davidasailor/PiForBoat/Diagrams/DataFlowDiagram.pptx

Data Flow Diagram

Web clients

Fridge Temp

Atmega328p

Home based server

Other banks V

RPMs

MFD

Pi Pico

Pi

Shunt

House Loads

Smart Shunt

House V, I, T

VOC’s

Bilge

NMEA Data

Water Levels

Temps
