davidasailor/PiForBoat/Diagrams/HighLevelTopology.pptx

High Level Topology

Smart Shunt for all
loads & chargers

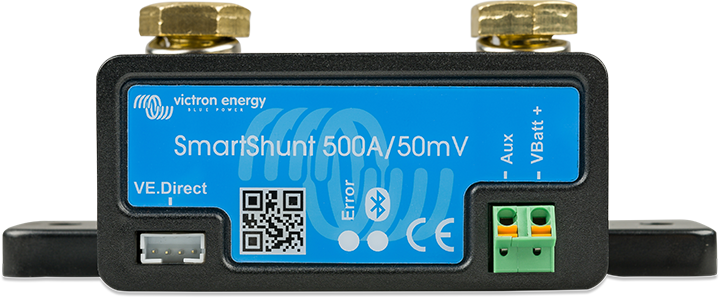
[picture p1: figure]
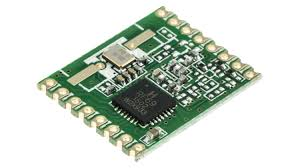
[picture p2: figure]

RFM69HCW

RFM69HCW

SPI + Int

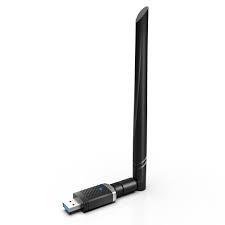
[picture p3: figure]

Wifi to marina
or hotspot

MFD Chartplotter

USB

UART

SPI

DS18B20
Refrigerator

Atmega328p

RFM69HCW

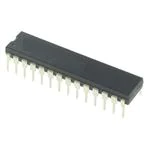
[picture p4: figure]
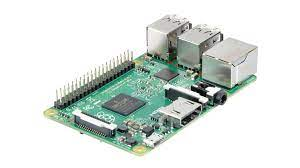
[picture p5: figure]
RASP PI 2 B 1.2 | Raspberry Pi 2 Model B v1.2 1GB | Distrelec Export Shop

Pi Model 2 B

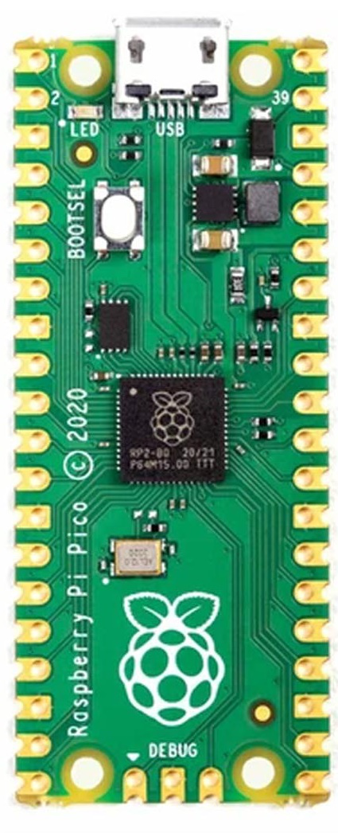
[picture p6: figure]

I2C

Ethernet

House Bank

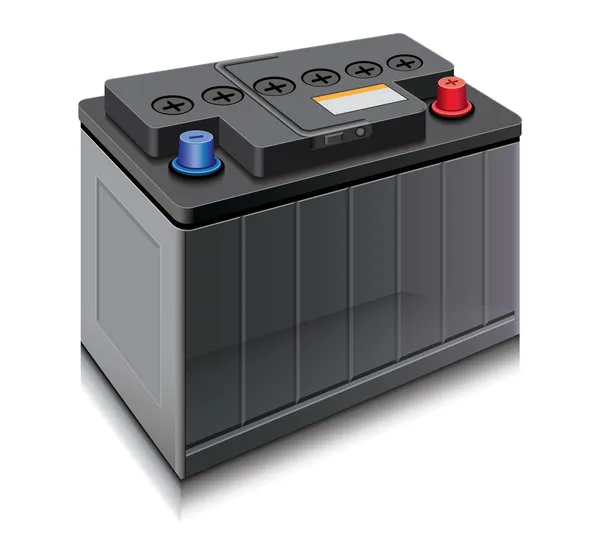
[picture p7: figure]

I2C

GPIO

Water Tank 1
Sensor

ADS1115

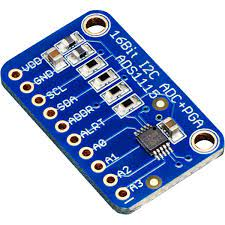
[picture p8: figure]
Adafruit 1085 ADC 16-bit Analogue to Digital Converter 4 Channel (ADS1115) | Rapid Online

USB

NMEA2K

Pi Pico

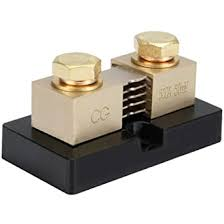
[picture p9: figure]

Water Tank 2
Sensor

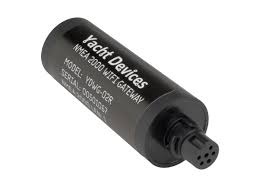
[picture p10: figure]
NMEA 2000 Wi-Fi Gateway YDWG-02 – Yacht Devices U.S. LLC

NMEA 2000 bridge

Shunt for house loads

Opto-Isolator

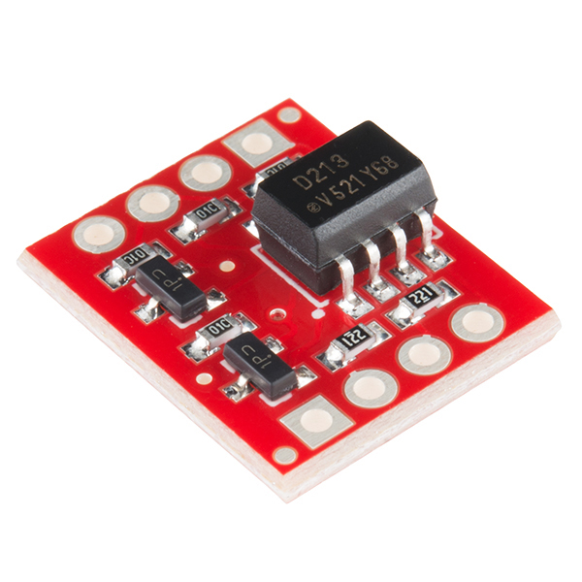
[picture p11: figure]
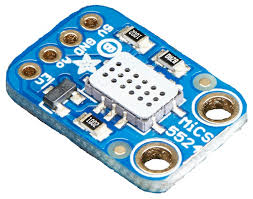
[picture p12: figure]

1-Wire

Engine Bank

MiCS5524
VOC Sensor

Bilge pump sensor

GPIO

Tach Out

DS18B20
Cabin

DS18B20
Engine

- All lines colored red have appropriate voltage dividers
- Power for Smart Shunt, Pico, and Pi not illustrated

DS18B20
Exhaust

Thruster Bank

ADS1115

Alternator

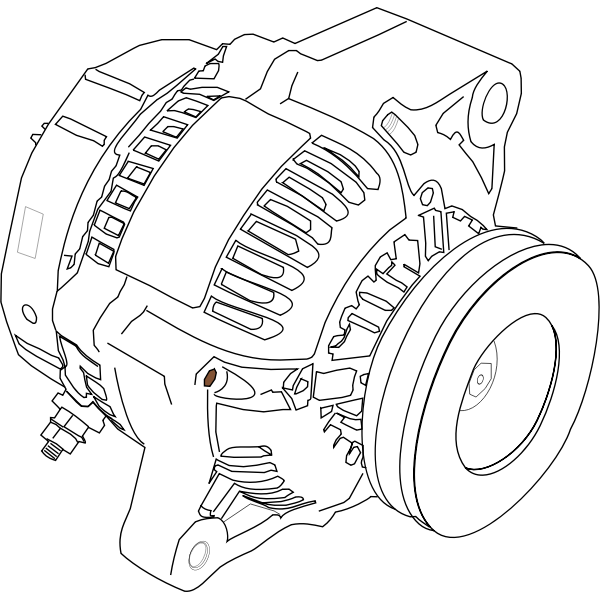
[picture p13: figure]
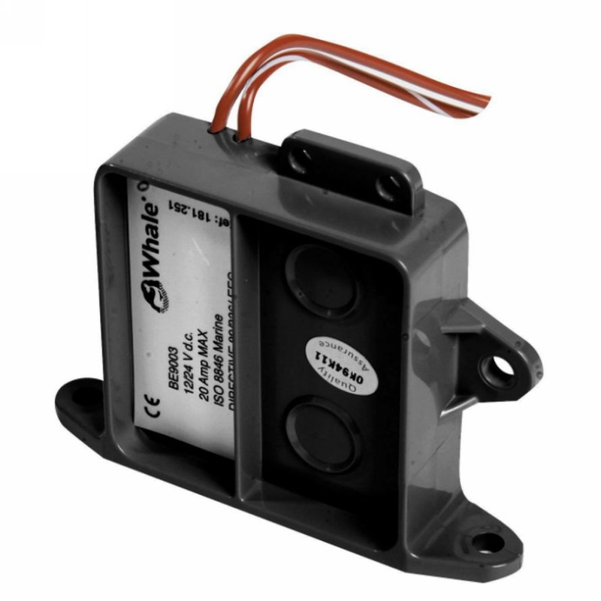
[picture p14: figure]
