davidasailor/PiForBoat/Screenshots/ElectricalDashboardTop.png

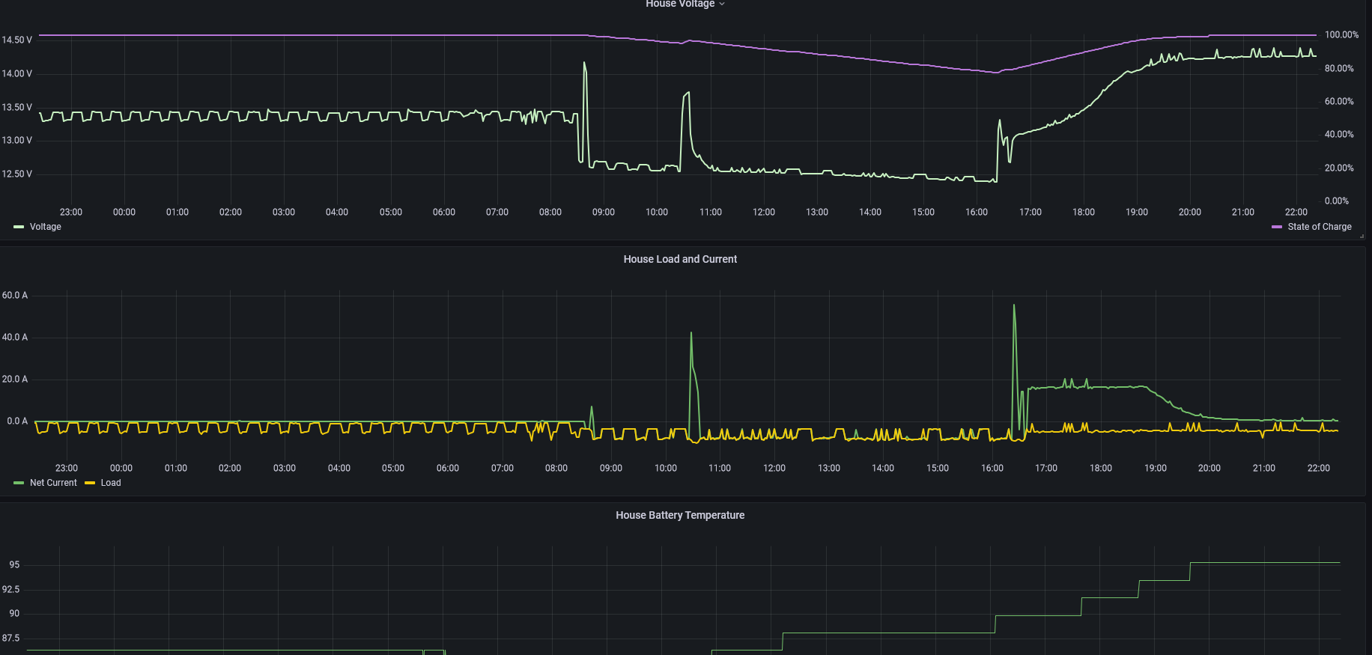
Screenshots/ElectricalDashboardTop.png
