davidasailor/PiForBoat/Screenshots/MainDashboardLower.png

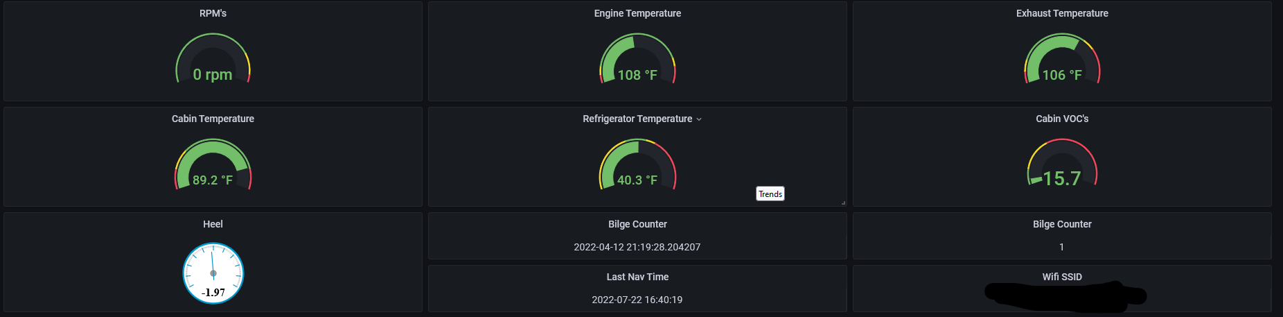
Screenshots/MainDashboardLower.png
