davidasailor/PiForBoat/Screenshots/MainDashboardTop.png

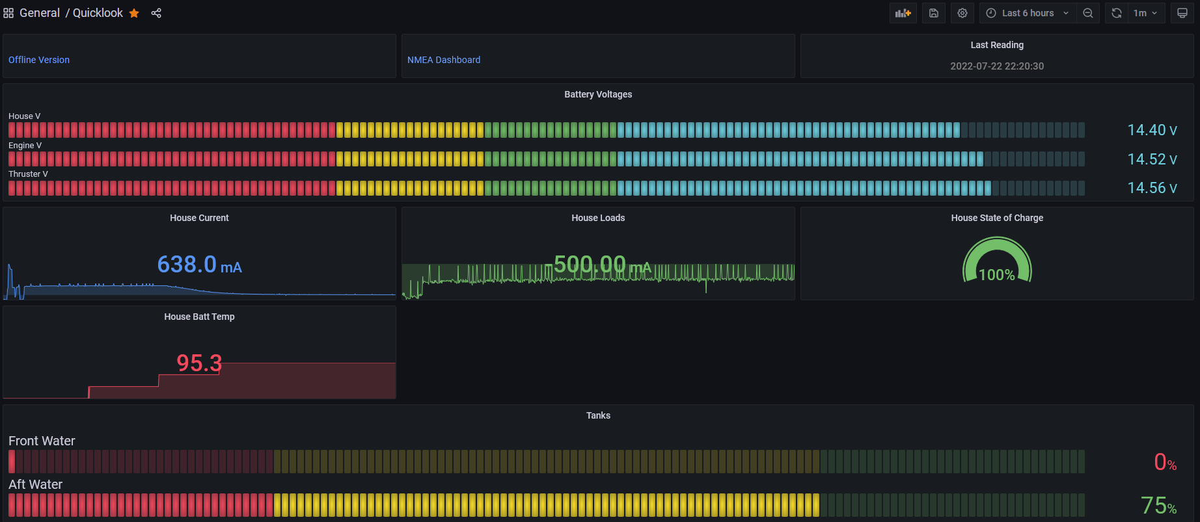
Screenshots/MainDashboardTop.png
