davidasailor/PiForBoat/Diagrams/DataFlowDiagram.pdf

## Data Flow Diagram

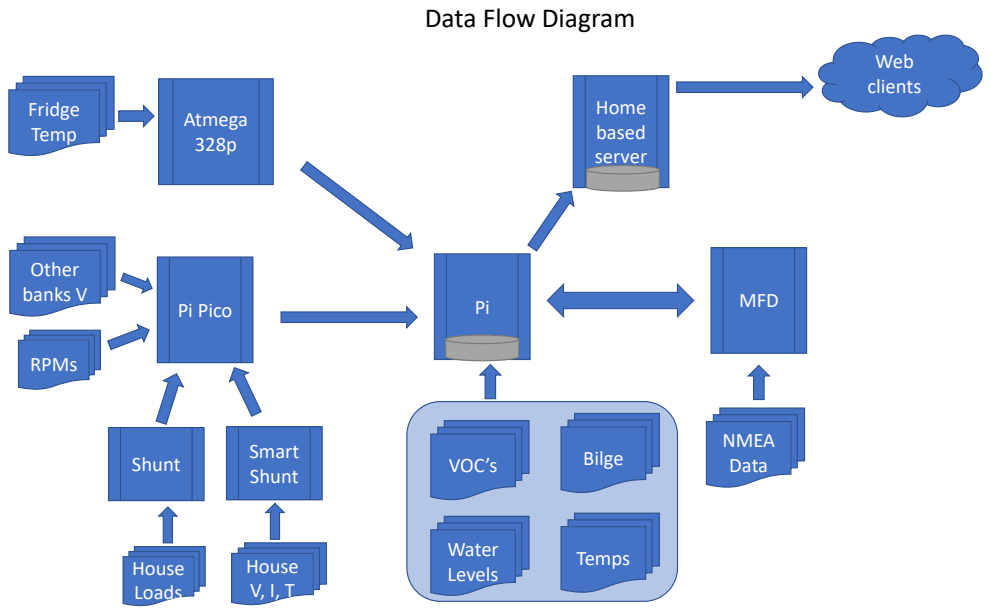
[picture p18: page 1]
Water Levels; Other banks V; RPMs; House Loads; Smart Shunt Shunt; House V, I, T; VOC’s; Temps; Bilge; NMEA Data; MFD; Web clients; Fridge Temp

Home based server

Atmega 328p

Pi Pico
