davidasailor/PiForBoat/(commit log)

2022-07-23 Uploading wifi-switcher script
2026-07-18 Update PiForBoat with recent improvements (bilge monitor, Signal K attitude fallback, BME680 support, and dynamic network switcher)
2026-07-21 Update: Note nmea_log RPM issue
    [PiForBoatPy.py]
2026-08-02 Update: fix(ci): replace 3-way squash merge with direct tree sync to eliminate merge conflicts
    [PiForBoatPy.py]
